kevindas1312/pick-and-place-robot-challenge-REC-Task-2-Group-5/hardware/schematic_rev1.1.png

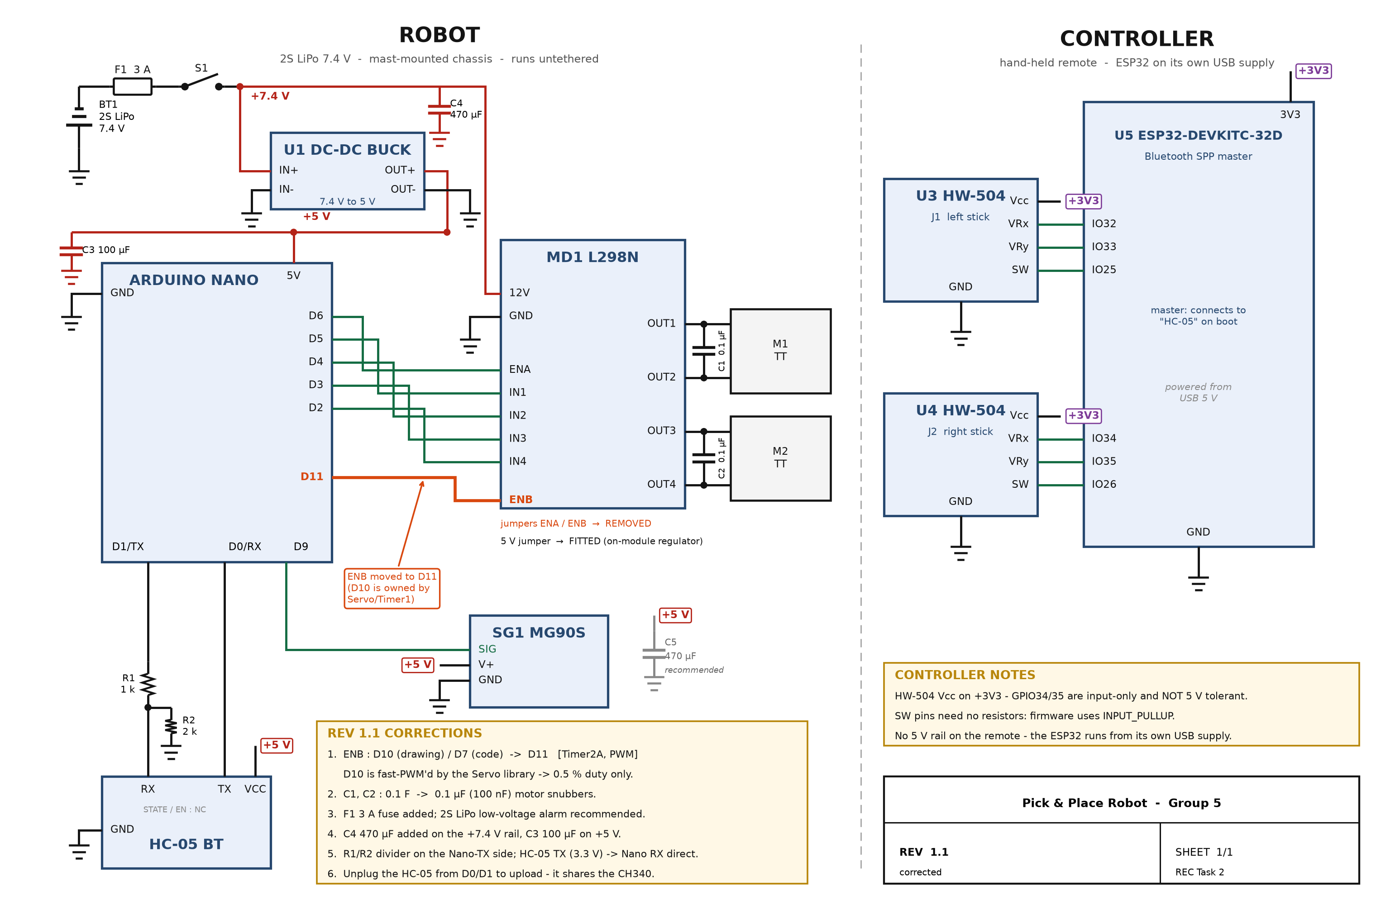
hardware/schematic_rev1.1.png
