kevindas1312/pick-and-place-robot-challenge-REC-Task-2-Group-5/(commit log)

2026-11-02 Clarify print results comment in joystick monitor
    Updated comment for clarity in joystick serial monitor.
2026-11-04 Add ESP32 Bluetooth controller code
2026-11-04 Add Arduino code for robot control with Bluetooth
    This code initializes an Arduino Nano to control a robot using an L298N motor driver and a servo for a claw mechanism. It listens for commands via Bluetooth to control movement and claw actions.
2026-11-04 schematic diagram alt
2026-11-05 Refactor motor control functions for clarity
2026-11-06 Decrease motor speed from 150 to 100
2026-11-06 Adjust turnSpeed for better robot maneuverability
    - Refactor turn speed to be 65% of int motorSpeed = 100
2026-11-06 Fix left motor polarity and retain debounced claw button commands
    [ArduinoStub.h, BluetoothSerial.h, arduino_nano_robot_RX_TX.ino, controller_code_ESP32.ino, controller_test.cpp, receiver_test.cpp, run_tests.py]
2026-11-06 Correct right motor polarity and verify claw packet delivery
    [BluetoothSerial.h, arduino_nano_robot_RX_TX.ino, integration_test.cpp, receiver_test.cpp, run_tests.py]
2026-11-06 Keep claw buttons responsive during Bluetooth connection attempts
2026-11-06 Reverse both motor polarities for corrected breadboard wiring
    [arduino_nano_robot_RX_TX.ino, integration_test.cpp, receiver_test.cpp]
2026-11-06 Revise motor speed comment for clarity
    Updated motor speed comment to reflect new values.
2026-11-06 Refine motor speed and claw angle settings
    Updated motor speed and claw angle constants for better performance.
2026-11-06 Refresh README for current robot firmware
